fbmarques-agios/WatchTower/(commit log)

2026-05-25 Add M5StickC Plus 1.1 build support
    - New PlatformIO env m5stickc_plus (board m5stick-c with variant
    override m5stack_stickc_plus, huge_app.csv partition for the
    4MB flash).
    - LCD support via M5Unified (header, boot status messages, live
    date/time/IP display). Library added only to the M5Stick env
    via lib_deps so the QT Py env is unchanged.
    - ANTENNA_DRIVE_LEVEL constant (0-3) using
    gpio_set_drive_capability to set the GPIO output strength,
    allowing the antenna coil to be tested without a series
    resistor at lower drive levels.
    - PIN_ANTENNA moved from GPIO13 (used by the M5Stick LCD) to
    GPIO26.
    - Default timezone changed to "BRT3" (America/Sao_Paulo, no DST).
    - Add p.pdf to .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
2026-05-25 Add PT-BR documentation for the M5StickC Plus build
    INSTRUCOES_M5STICK.md covers flashing with PlatformIO, WiFi
    captive portal setup, what the LCD shows, antenna coil wiring
    with the two drive-level modes, and Citizen H874 specifics
    (timezone mapping for WWVB, manual reception procedure,
    reference position correction).
2026-05-25 Guard M5Stick-only code from the native test build
    test/test_native/test_bootstrap.cpp includes WatchTower.ino directly
    and the M5Stick additions (M5Unified, driver/gpio.h, IPAddress::toString,
    constrain) are not available in the host-side mocks.
    Wrap the additions in `#ifndef UNIT_TEST` blocks and provide no-op
    stubs so `pio test -e native` keeps passing (5/5 tests pass).
2026-05-25 Add CLAUDE.md project guide
    Concise guide for Claude Code working in this repository:
    - Project overview and what this fork adds on top of upstream
    - Architecture diagram (NTP -> ESP32 LEDC PWM -> GPIO26 -> coil -> watch)
    - Build environments table (m5stickc_plus, adafruit_qtpy_esp32, native)
    - Key files and commands (build, upload, monitor, native tests, hooks)
    - Design decisions and dev-time gotchas (PIN_ANTENNA=26, variant override,
    partition table, M5Unified scoping, ANTENNA_DRIVE_LEVEL semantics,
    WWVB encoding, UNIT_TEST guards)
    - Documentation routing table
    Modeled after the CLAUDE.md style used in the sibling soc-bot-abasp
    project (architecture + commands + dev landmines + doc ro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
2026-05-25 Add pre-commit/pre-push git hooks
    - .githooks/pre-commit: runs `pio run -e m5stickc_plus` to catch
    firmware compile errors before each commit (~10-20 s with cache).
    - .githooks/pre-push: same build + `pio test -e native` (the host-
    side Unity tests for the WWVB encoder).
    Both gracefully skip if PlatformIO isn't installed at the expected
    path. Install for this clone with:
    git config core.hooksPath .githooks
    Mirrors the lint-then-test hook pattern used in the sibling
    soc-bot-abasp project (cheap check pre-commit, expensive check
    pre-push).
2026-05-25 Quiet arduino-builder: hoist color macros above the UNIT_TEST guard
    The arduino-builder prototype generator text-scans both branches of
    `#ifndef`/`#else` while building auto-prototypes, so duplicate
    `#define`s in the two branches produced "macro redefined" warnings
    on every clean build of `m5stickc_plus`.
    Move the C_* color macros to a single block above the `#ifndef
    UNIT_TEST`. They're plain numeric constants and harmless to both
    branches; the stub block doesn't need its own definitions.
    Build output is now warning-free.
    [WatchTower.ino]
2026-05-25 Rewrite README in PT-BR as the fork's canonical user manual
    - Replace the upstream English README with a Portuguese version
    focused on the M5StickC Plus path. The upstream content remains
    available in git history and at github.com/emmby/WatchTower for
    the original QT Py + DRV8833 build.
    - Cover the fork's new features (LCD via M5Unified,
    ANTENNA_DRIVE_LEVEL, BRT3 timezone, m5stickc_plus env) and
    absorb the content of INSTRUCOES_M5STICK.md (now deleted -- one
    source of truth).
    - Add a dedicated section for the Citizen H874 watch: timezone
    configuration (UTC-3 = WWVB station), antenna location (9
    o'clock), manual reception procedure, reference position
    correction (manual page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
2026-05-29 Rewrite README as winning success story + lessons learned
    The TB6612 amplifier circuit + Citizen H874 reception was confirmed
    working in May 2026 after extensive debugging. This rewrite shifts
    the README from "build guide" to "celebrated success story + hard-won
    lessons" - the version to share publicly in watch enthusiast groups.
    Major changes:
    - New status badge: TESTED AND WORKING with Citizen H874
    - Strong "who is this for" hook for watch enthusiasts
    - Detailed 8-item "lessons learned" section - the gold of this
    project. Anyone replicating saves days of blind debugging.
    - Hardware shopping list with prices (May/2026 Brazilian market)
    - Multimeter prominently flagged as MANDATORY, not o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
2026-05-29 Add project photos to README
    Four photos illustrating the build and the result:
    - montagem-funcionando.jpg: hero shot of the working setup
    (M5Stick + TB6612 + ferrite + Citizen H874 receiving)
    - citizen-h874.jpg: the target watch, with multiband dial visible
    - componentes.jpg: hardware spread out before assembly
    - tb6612-pinout.jpg: clear top-down view of the TB6612 breakout
    so readers can map the wiring table to physical pins
    Saved under docs/images/ so they have a stable home if more
    diagrams/photos are added later (definitive build, 3D case).
